TomPlano/AVRC-2560/README.md

# AVRC-2560
Project for interfacing Atmega2560 to the rcbus
