TomPlano/AVRC-2560/photos/pcb_back.png

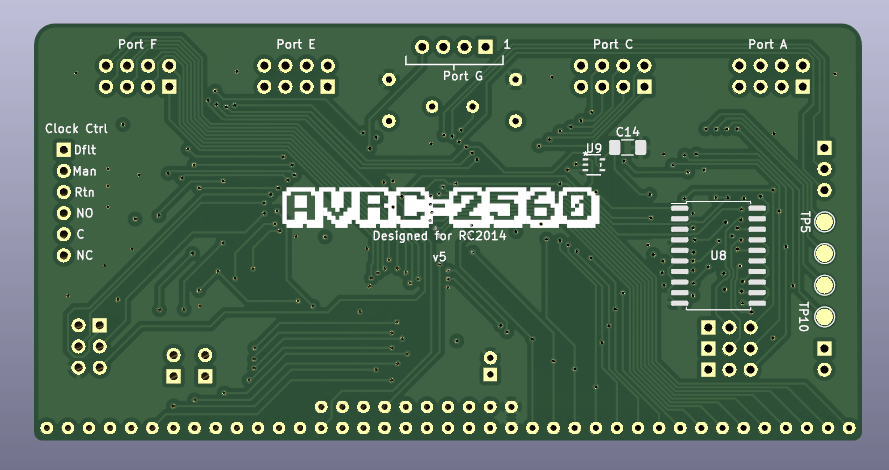
photos/pcb_back.png
