TomPlano/AVRC-2560/photos/pcb_front.png

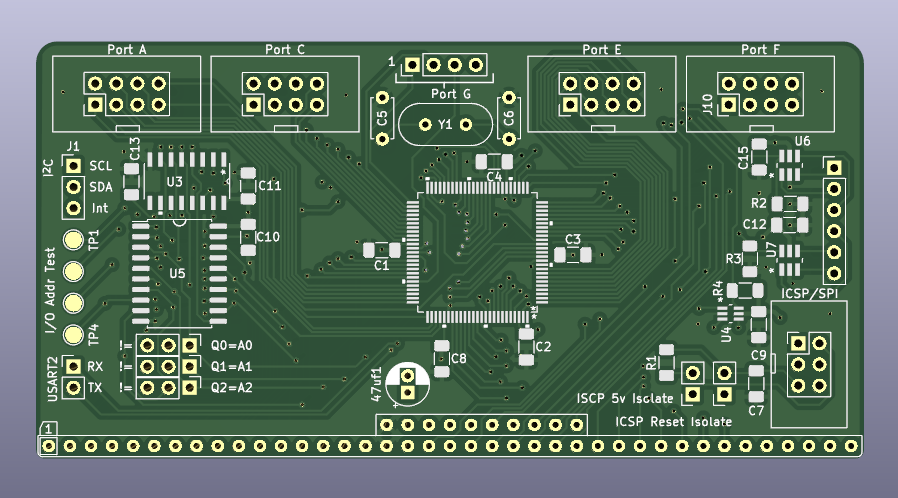
photos/pcb_front.png
