TomPlano/AVRC-2560/photos/back.pdf

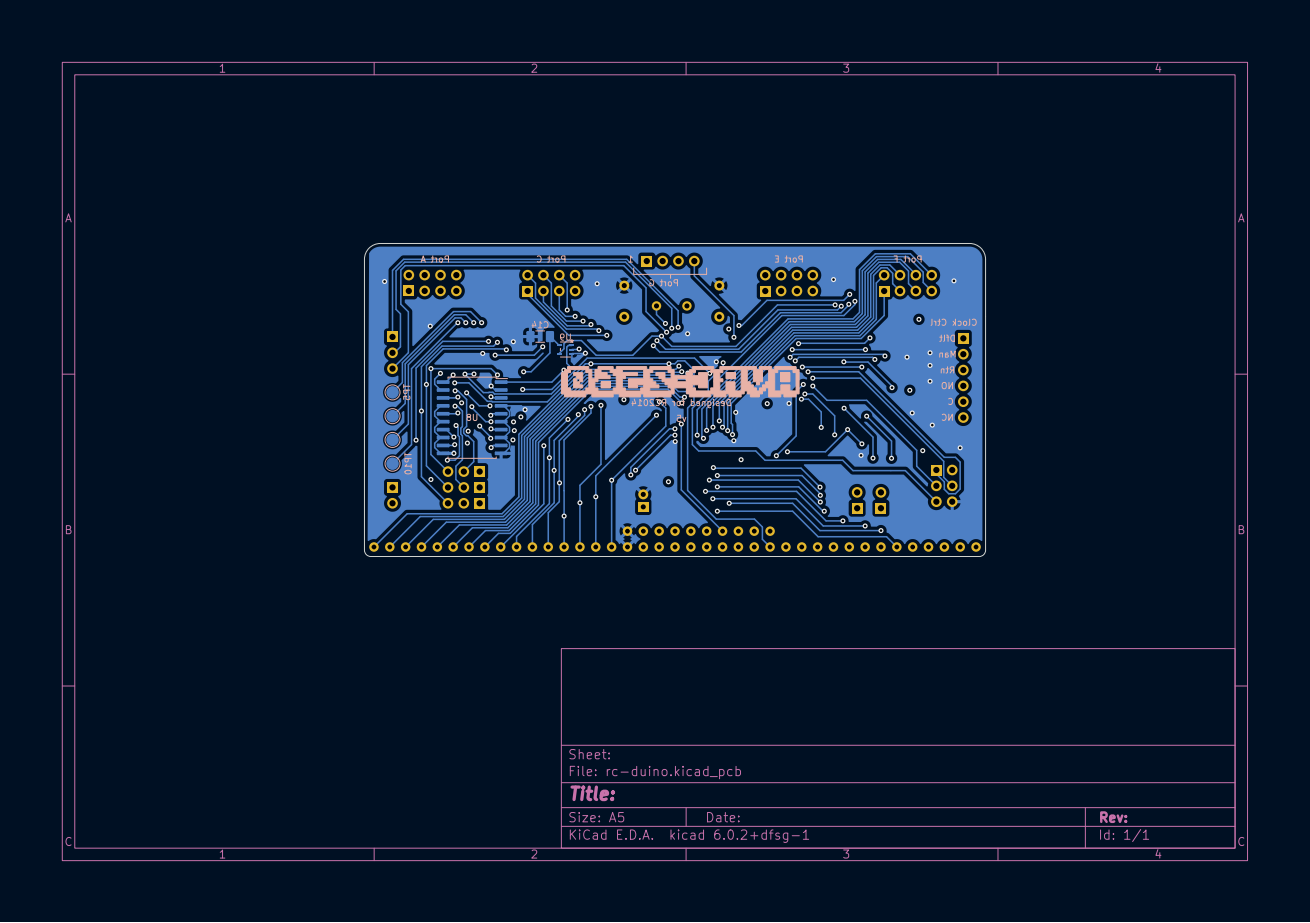
[picture p3: page 1]
