TomPlano/AVRC-2560/photos/front.pdf

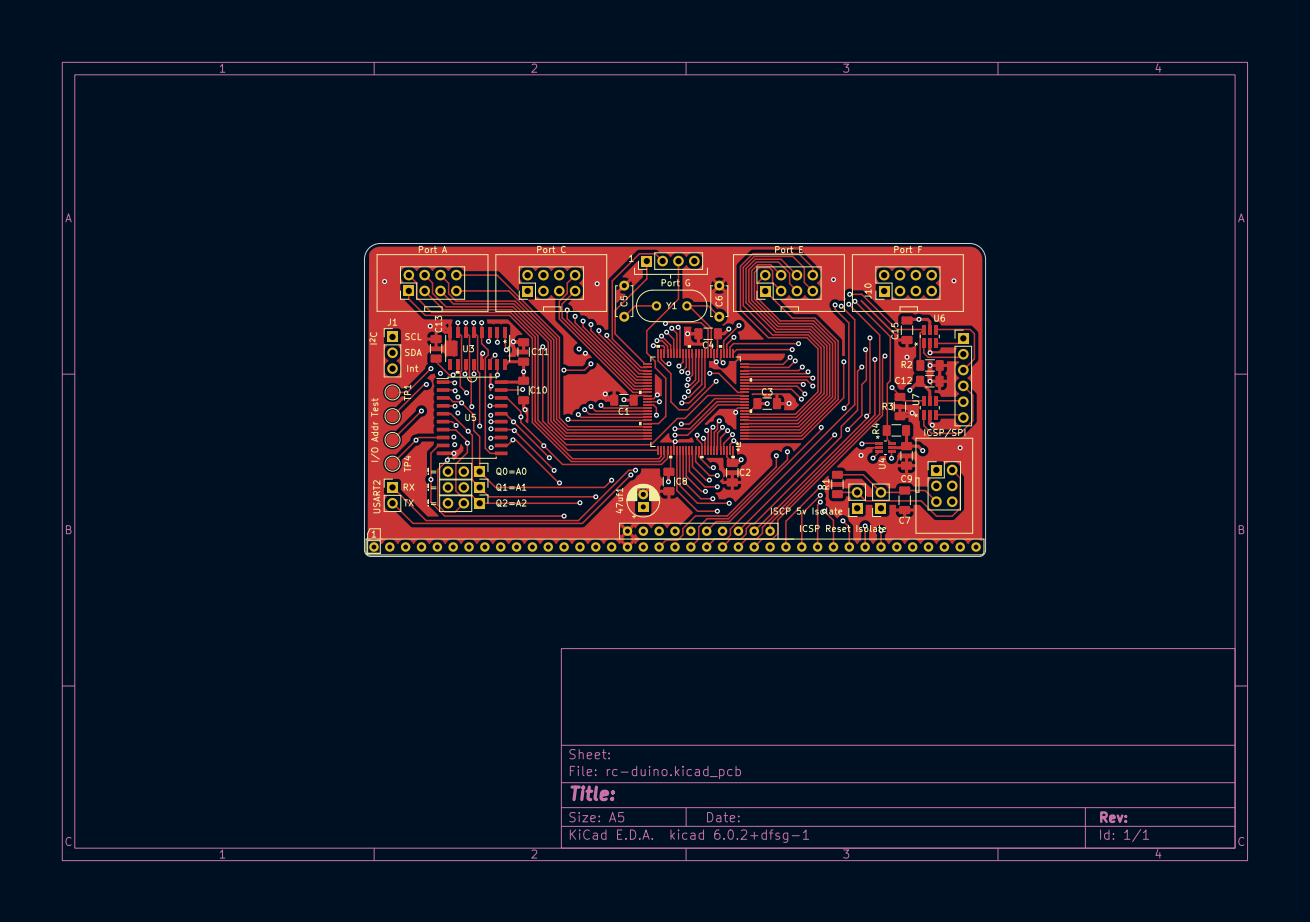
[picture p4: page 1]
