TomPlano/AVRC-2560/photos/in1.pdf

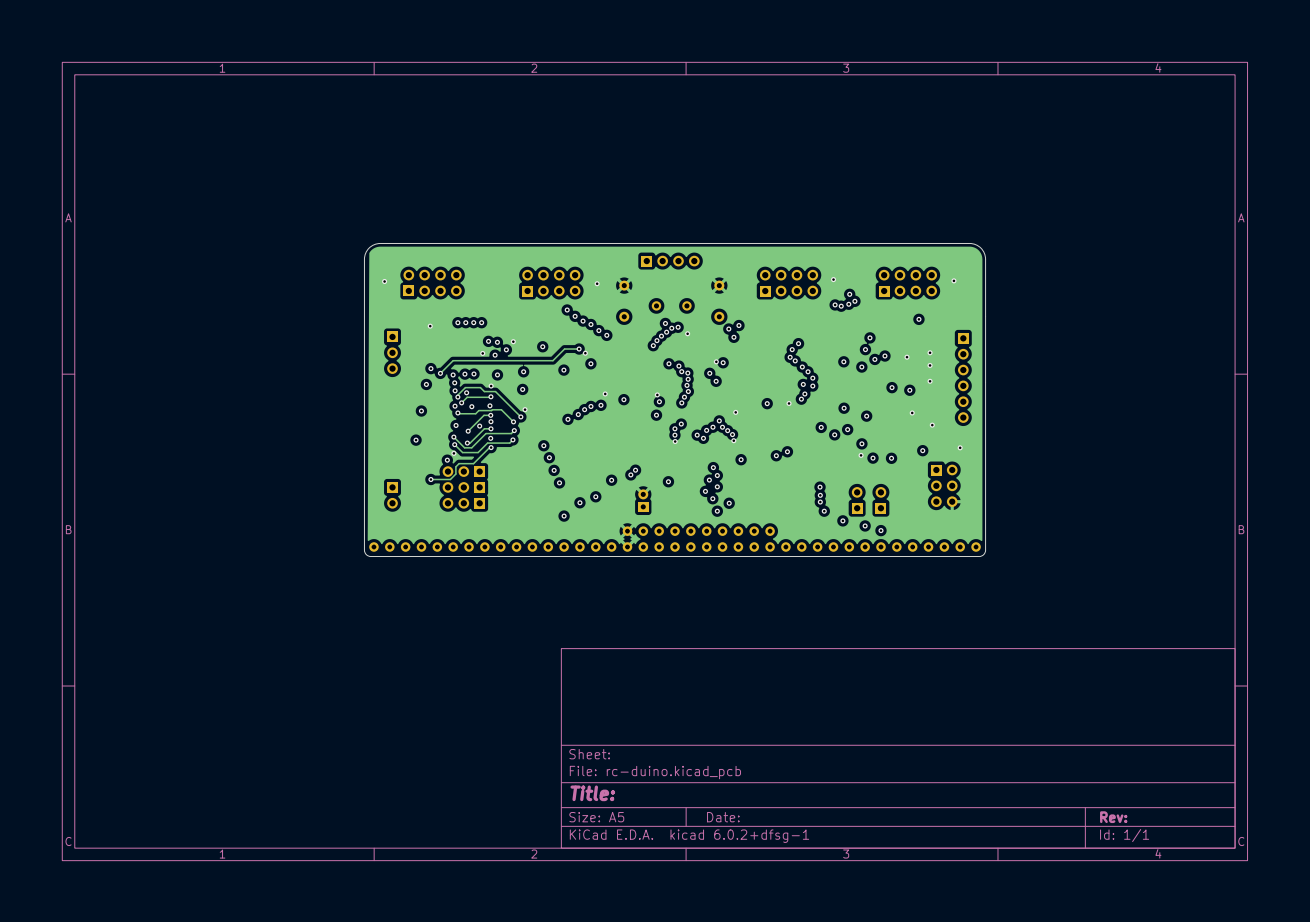
[picture p5: page 1]
