TomPlano/AVRC-2560/photos/in2.pdf

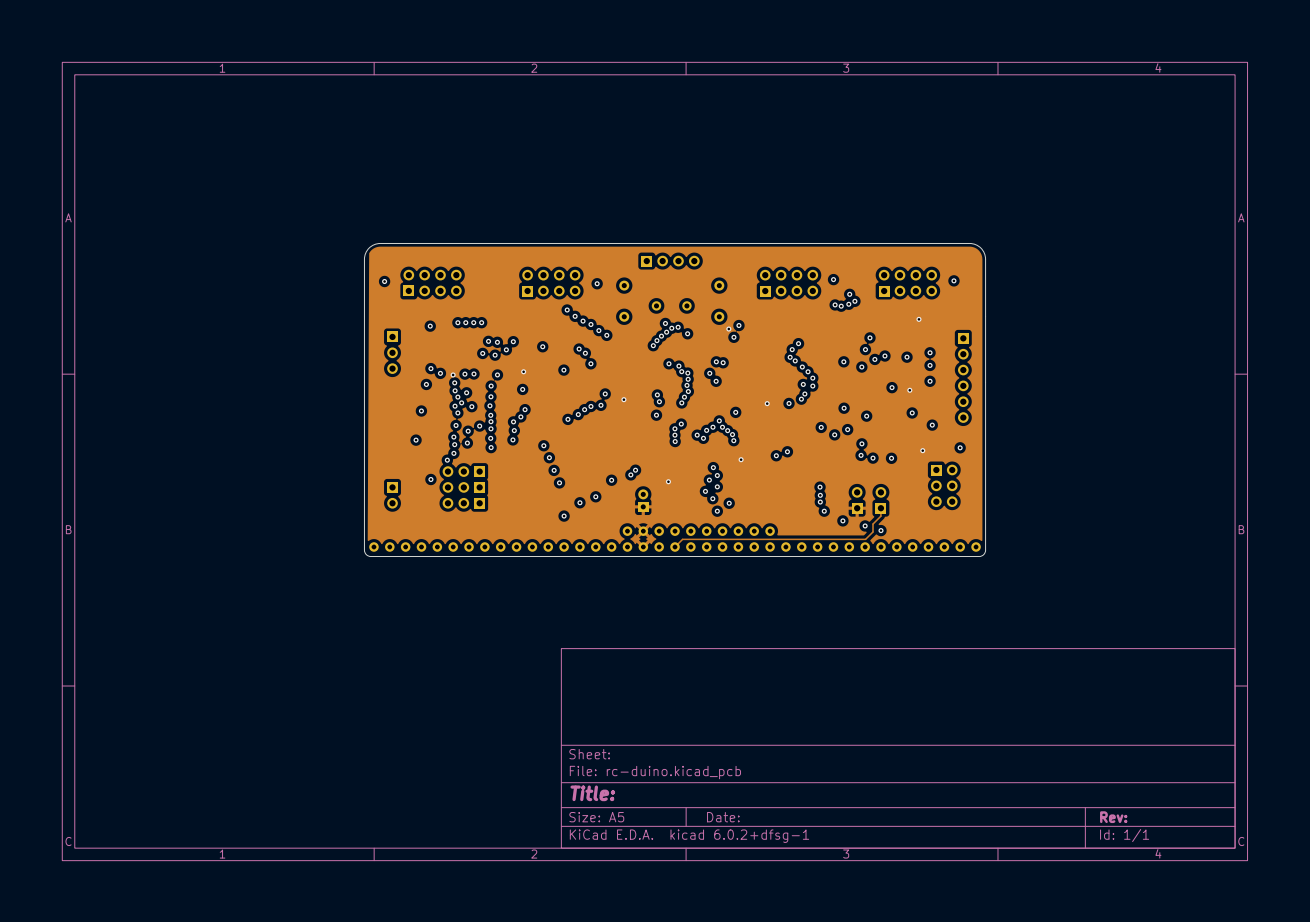
[picture p6: page 1]
