TomPlano/AVRC-2560/firmware/NoRTOS/avrc2560_core.h

#ifndef ACRV2560CORE_H
#define ACRV2560CORE_H

//cmd line for flashing a fresh board
//avrdude.exe "-CC:\Users\tompl\AppData\Local\Arduino15\packages\arduino\tools\avrdude\6.3.0-arduino17/etc/avrdude.conf" -v -V -patmega2560 -cstk500v2 -Pusb -U lfuse:w:0xff:m -U hfuse:w:0x98:m -U efuse:w:0xff:m 

#include <avr/interrupt.h>
#include <avr/io.h>


#define INT_DISABLE 0
#define INT_ENABLE 0

#define PCINT_DISABLE 0
#define PCINT_ENABLE 0



/**
 * Address Bus (A/C)
 */
#define ADDRLO_DDR DDRA
#define ADDRLO_PORT PORTA
#define ADDRLO_PIN PINA

#define ADDRHI_DDR DDRC
#define ADDRHI_PORT PORTC
#define ADDRHI_PIN PINC

#define GET_ADDRLO ADDRLO_PIN
#define SET_ADDRLO(addr) ADDRLO_PORT = (addr)

#define GET_ADDRHI ADDRHI_PIN
#define SET_ADDRHI(addr) ADDRHI_PORT = (addr)

#define GET_ADDR (GET_ADDRLO | (GET_ADDRHI << 8))
#define SET_ADDR(addr) (SET_ADDRLO((addr) & 0xFF), SET_ADDRHI((addr) >> 8))

#define ADDR_INPUT (ADDRLO_DDR = 0x00, ADDRHI_DDR = 0x00)
#define ADDR_OUTPUT (ADDRLO_DDR = 0xFF, ADDRHI_DDR = 0xFF)
#define ADDR_TSTATE  (ADDR_INPUT, ADDRLO_PORT=0x00,ADDRHI_PORT=0x00)
/**
 * Data Bus (L)
 */
#define DATA_DDR DDRL
#define DATA_PORT PORTL
#define DATA_PIN PINL

#define DATA_INPUT DATA_DDR = 0x00
#define DATA_OUTPUT DATA_DDR = 0xFF
#define DATA_TSTATE (DATA_INPUT, DATA_PORT = 0x00)

#define GET_DATA DATA_PIN
#define SET_DATA(data) DATA_PORT = (data)

/**
 * Port B Map
 */

#define M1 (1 << PINB0)
#define SPI_CLK (1 << PINB1)
#define SPI_MOSI (1 << PINB2)
#define SPI_MISO (1 << PINB3)
#define CLK (1 << PINB4)
#define INT (1 << PINB5)
#define MREQ (1 << PINB6)
#define WR (1 << PINB7)

/**
 * Port B Manipulation
 */

#define GET_M1 (PINB & M1)
#define GET_CLK (PINB & CLK)
#define GET_INT (PINB & INT)
#define GET_MREQ (PINB & MREQ)
#define GET_WR (PINB & WR)

/**
 * Port D Map
 */
#define I2C_SCL  (1 << PIND0)
#define I2C_SDA (1 << PIND1)
#define I2C_INT (1 << PIND2)
#define PORT_IO_REQUEST (1 << PIND3)
#define PORT_SR_CLK (1 << PIND4)
#define PORT_SR_DATA (1 << PIND5)
#define IORQ (1 << PIND6)
#define IO_ADDR_COMP (1 << PIND7)

/**
 * Port D Manipulation
 */
#define GET_PORT_IO_REQUEST (PIND & PORT_IO_REQUEST)
#define GET_PORT_SR_CLK (PIND & PORT_SR_CLK)
#define GET_PORT_SR_DATA (PIND & PORT_SR_DATA)
#define GET_IORQ (PIND & IORQ)

#define IO_ADDR_COMP_HI PIND |= IO_ADDR_COMP
#define IO_ADDR_COMP_LO PIND &= ~IO_ADDR_COMP

#define PORT_SR_DATA_HI PORTD |= PORT_SR_DATA
#define PORT_SR_DATA_LO PORTD &= ~PORT_SR_DATA

#define PORT_SR_CLK_HI PORTD |= PORT_SR_CLK
#define PORT_SR_CLK_LO PORTD &= ~PORT_SR_CLK
#define PORT_SR_CLK_TOG (PORT_SR_CLK_HI, PORT_SR_CLK_LO)

/**
 * Port G Map
 */


/**
 * Port H Map
 */
#define UART2_RX  (1 << PINH0)
#define UART2_TX (1 << PINH1)

#define BUSACK (1 << PINH2)
#define HALT (1 << PINH3)
#define BUSRQ (1 << PINH4)
#define WAIT (1 << PINH5)
#define NMI (1 << PINH6)
#define RD (1 << PINH7)

/**
 * Port H Manipulation
 */
#define GET_BUSACK (PINH & BUSACK)
#define GET_HALT (PINH & HALT)
#define GET_BUSRQ (PINH & BUSRQ)
#define GET_WAIT  (PINH & WAIT)
#define GET_NMI (PINH & NMI)
#define GET_RD  (PINH & RD)


#define BUSRQ_HI PORTH |= BUSRQ
#define BUSRQ_LO PORTH &= ~BUSRQ

#define BUSRQ_MODE_IN DDRH = DDRH | BUSRQ
#define BUSRQ_MODE_OUT DDRH = DDRH & ~BUSRQ


/**
 * DDR defaults
 */

//PB =  WR,MREQ,INT,CLK,prog_miso,prog_mosi,prog_sck,m1
#define DDRB_DEFAULT 0x00
//PD = ~IO_addr_comp, ~IORQ, port_sr_clk,port_sr_data, ~portIOReq, ~i2c int,SDA,SCL
#define DDRD_DEFAULT 0b10011011
//PH = RD,NMI,~WAIT,BusRQ,HALT,BusAck,uart2_tx,uart2_rx
#define DDRH_DEFAULT 0b00000010


/**
 * Pullup defaults
 */
//PB =  WR,MREQ,INT,CLK,prog_miso,prog_mosi,prog_sck,m1
#define PORTB_DEFAULT 0x0
//PD = ~IO_addr_comp, ~IORQ, port_sr_clk,port_sr_data, ~portIOReq, ~i2c int,SDA,SCL
#define PORTD_DEFAULT 0x00
//PH = RD,NMI,~WAIT,BusRQ,HALT,BusAck,uart2_tx,uart2_rx
#define PORTH_DEFAULT 0x0



//ISR related global data 
volatile byte direction = 0;
volatile byte indata = 0; //data recived from host
volatile byte outData = 0; // data staged from sending to host 
volatile byte err = 0;
volatile bool hostIOOccured = false;


#define RCBUS_BUFFER_SIZE 64

volatile byte rcbus_output_buffer[RCBUS_BUFFER_SIZE] = {0};
volatile byte rcbus_input_buffer[RCBUS_BUFFER_SIZE] = {0};

volatile byte rcbus_input_head = 0;
volatile byte rcbus_input_tail = 0;

volatile byte rcbus_output_head = 0;
volatile byte rcbus_output_tail = 0;


ISR(INT3_vect) {
  /*
  Init State:
  shift register Q0-7 contain the address that the avr will listen on, set at boot
  ~{PortIOREquest} pulled up by mcu internal resistor
  ~{IO_add_comp} is held low, flip flop passing ioreq out to wait
  A0-7 + ~{IORQ} are non-matching

  IO sequence:
  1. cpu brings iorq rd/wt low with matching port address on bus
  2. portIOrequest goes low after matching addr[2:7] with sr[2:7]  and gets latched onto waitline with next clk pulse
  2.5 avr falling edge intterrupt trigger on portIOrequest
  3. avr checks RD and WR lines to determine what request is being made

  Timing Notes:
  Single 8bit Read, from iorq going low to wait and busreq release : between 8 and 9 us (58 to 66 clock cycles, 15 to 17 machine cycles )
  Single 8bit Write, from iorq going low to wait release : between 8 and 6.5 us (44 to 48 clock cycles, 11 to 12 machine cycles)

  will need to retime after next revision and removal of hash/unhash functions

  */

  //report IO to rest of AVR
  hostIOOccured = true;


  //read ~WR and ~RD pins
  err = 0;
  byte _WRPin = GET_WR;
  byte _RDPin = GET_RD;

  if (_WRPin != WR && _RDPin == RD) {
    /*
      if z80 write to module:
        1. avr data pins default to input/high Z and collects value
        2. avr tristate decoding logic by brining ~{IO_add_comp} low, wait goes high from pullup on cpu card, latch is set high on next clk pluse
      */
    //read data bus
    //indata = GET_DATA;
    // write the byte recieved from z80 into the input buffer of the module
    rcbus_input_buffer[rcbus_input_head]  = GET_DATA;
    // bump along rcbus_input_head around circular buffer 
    rcbus_input_head = ((++rcbus_input_head) % RCBUS_BUFFER_SIZE);
    
    // inline asm to make to compiler and timing behave
    asm("sbi %0, %1 \n"
        "nop\n"
        "nop\n"
        "nop\n"
        "nop\n"
        "nop\n"
        "nop\n"
        "nop\n"
        "nop\n"
        "nop\n"
        "cbi %0, %1 \n"
        :
        : "I"(_SFR_IO_ADDR(PORTD)), "I"(PORTD7));
    return;
  } else if (_RDPin != RD && _WRPin == WR) {
    /*
      if z80 read from module:
        4. avr sets databus to output , and output low, then  sets value
        5. avr then asserts the busreq line to essentially stall the cpu in tristate after the databus has been read
        6. avr tristate decoding logic by brining ~{IO_add_comp} high , wait goes high from pullup on cpu card, latch is set high on next clk pluse
        7. cpu reads data lines now that wait is clear
        8. cpu sees asserted bus req at begining of last m cycle of read
        9. cpu tristates its pins
        10. avr Poll on busack, proceed after it goes low
        11. avr tristate the databus
        12. avr reenable address decoding by brining ~{IO_add_comp} low
        13. avr release busreq
      */
    //set data lines to output
    DATA_OUTPUT;
    //clear databus
    SET_DATA(0x00);
    //output true data
    //SET_DATA(outData);
    
    //output true data
    SET_DATA(rcbus_output_buffer[rcbus_output_tail]);
    //bump along rcbus_output_tail around circular buffer  
    rcbus_output_tail = ((++rcbus_output_tail) % RCBUS_BUFFER_SIZE);
    
    //set busreq to output
    BUSRQ_MODE_OUT;

    //assert bus req low
    BUSRQ_LO;
    
    //avr tristate decoding logic by brining ~{IO_add_comp} high
    asm("sbi %0, %1 \n"
        :
        : "I"(_SFR_IO_ADDR(PORTD)), "I"(PORTD7));
    // wait for cpu to read data, this will be indicated by bus ack going low on pinh5, use avrlibc/io for stibility
    loop_until_bit_is_clear(PINH, 5);

    //trisatate data bus
    DATA_TSTATE;
    // reanable addr decode
    asm("cbi %0, %1 \n"
        :
        : "I"(_SFR_IO_ADDR(PORTD)), "I"(PORTD7));
    // release busreq and set to high Z
    PORTH = PORTH | BUSRQ;
    //set busreq to input
    BUSRQ_MODE_IN;
    
  } else {
    err = 1;
  }
}

void ioaddrSet(byte addr) {
  byte i;
  for (i = 0; i < 8; i++) {
    PORT_SR_DATA_LO;
    PORT_SR_CLK_TOG;
  }
  for (i = 0; i < 8; i++) {
    //digitalWrite(SRDATA, (addr & 128) != 0);
    ((addr & 128) != 0) ? PORT_SR_DATA_HI : PORT_SR_DATA_LO;
    addr <<= 1;
    PORT_SR_CLK_TOG;
  }
  PORT_SR_CLK_TOG;
}

void initRCBus(bool installed){
  DATA_TSTATE;
  ADDR_TSTATE;
    //Board is installed in the system
    DDRB = DDRB_DEFAULT;
    DDRD = DDRD_DEFAULT;
    DDRH = DDRH_DEFAULT;
    
    PORTB = PORTB_DEFAULT;
    PORTD = PORTD_DEFAULT;
    PORTH = PORTH_DEFAULT;
  ioaddrSet(0xFF);  //203
  
}

void enableRCbusinterrupt(){
    //set up port IO interrup ctrl,
  EIMSK = 0b00000000;          //disable INT3&INT2 before setting its mode
  EICRA = 0b10000000;          //INT3 triggers on FALLING EDGE (poit IO request)
  EIMSK = 0b00001100;          //enable INT3 and 2
  IO_ADDR_COMP_LO;  //force ~IO_addr_comp (pd7) low, enabling wait latching

}

void initUserPorts(){
  //set unused user ports to highz
  DDRE = 0;
  DDRF = 0;
  DDRG = 0;
  DDRJ = 0;
  DDRK = 0;
  PORTE = 0xFF;
  PORTF = 0xFF;
  PORTG = 0xFF;
  PORTJ = 0xFF;
  PORTK = 0xFF;
}
void allHighZ(){
  DDRA = 0;
  DDRB = 0;
  DDRC = 0;
  DDRD = 0;
  DDRE = 0;
  DDRF = 0;
  DDRG = 0;
  DDRH = 0;
  DDRJ = 0;
  DDRK = 0;
  DDRL = 0;


  PORTA = 0xFF;
  PORTB = 0xFF;
  PORTC = 0xFF;
  PORTD = 0xFF;
  PORTE = 0xFF;
  PORTF = 0xFF;
  PORTG = 0xFF;
  PORTH = 0xFF;
  PORTJ = 0xFF;
  PORTK = 0xFF;
  PORTL = 0xFF;
  
}

#endif /*ACRV2560CORE_H*/
