TomPlano/AVRC-2560/(commit log)

2024-01-12 first push for public review
    [rc-duino.kicad_pcb, rc-duino.kicad_sch]
2024-01-18 got encoders working as external dev
2024-01-22 revising code into multitasking freeRTOS implementation
    [rc-duino.kicad_sch]
2024-02-17 checking in before major relayout of ctrl board
2024-09-04 major rework
    [rc-duino-B_Cu.gbr, rc-duino-B_Mask.gbr, rc-duino-B_Paste.gbr, rc-duino-B_Silkscreen.gbr, rc-duino-Edge_Cuts.gbr, rc-duino-F_Cu.gbr, rc-duino-F_Mask.gbr, rc-duino-F_Paste.gbr]
2024-10-31 checkout before reimage
    [rc-duino.kicad_pcb, rc-duino.kicad_sch]
